zakqwy/NSA-B-GONE/HARDWARE/NSA-B-GONE.kicad_pcb

## KiCad design HARDWARE/NSA-B-GONE.kicad_pcb (2019-03-12)

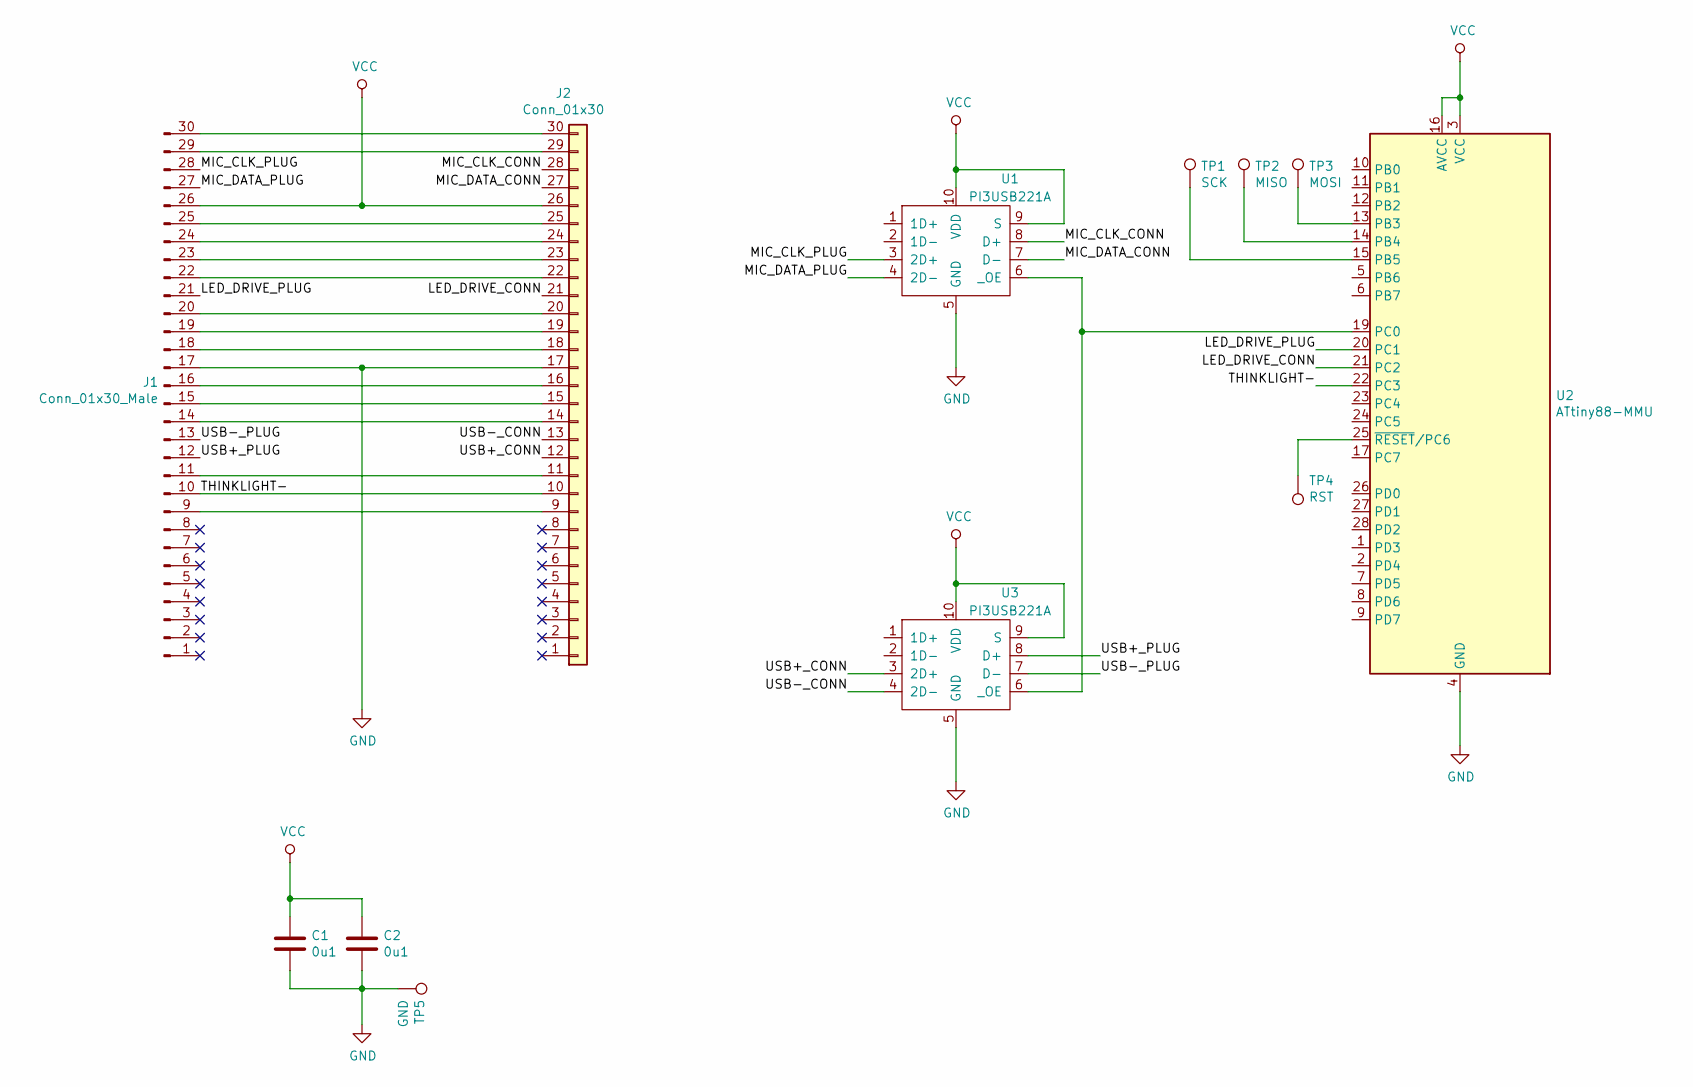
[picture p7: schematic NSA-B-GONE.sch]

Parts:
C1, C2: 0u1; C_0402_1005Metric
J1: Conn_01x30_Male; ZF_CONN_30PIN_FLEX_PLUG
J2: Conn_01x30; ZF_CONN_30PIN_FLEX_CONN
TP1: SCK; TestPoint_Pad_D1.5mm
TP2: MISO; TestPoint_Pad_D1.5mm
TP3: MOSI; TestPoint_Pad_D1.5mm
TP4: RST; TestPoint_Pad_D1.5mm
TP5: GND; TestPoint_Pad_1.5x1.5mm
U1, U3: PI3USB221A; ZF_IC_10_UQFN
U2: ATtiny88-MMU; QFN-28-1EP_4x4mm_P0.45mm_EP2.4x2.4mm

Connections:
/LED_DRIVE_CONN: J2.21, U2.21 (PC2)
/LED_DRIVE_PLUG: J1.21, U2.20 (PC1)
/MIC_CLK_CONN: J2.28, U1.8 (D+)
/MIC_CLK_PLUG: J1.28, U1.3 (2D+)
/MIC_DATA_CONN: J2.27, U1.7 (D-)
/MIC_DATA_PLUG: J1.27, U1.4 (2D-)
/THINKLIGHT-: J1.10, J2.10, U2.22 (PC3)
/USB+_CONN: J2.12, U3.3 (2D+)
/USB+_PLUG: J1.12, U3.8 (D+)
/USB-_CONN: J2.13, U3.4 (2D-)
/USB-_PLUG: J1.13, U3.7 (D-)
GND: C1.2, C2.2, J1.17, J2.17, TP5.1, U1.5 (GND), U2.4 (GND), U2.18 (GND), U2.29 (GND), U3.5 (GND)
unnamed: J1.9, J2.9
unnamed: J1.11, J2.11
unnamed: J1.14, J2.14
unnamed: J1.15, J2.15
unnamed: J1.16, J2.16
unnamed: J1.18, J2.18
unnamed: J1.19, J2.19
unnamed: J1.20, J2.20
unnamed: J1.22, J2.22
unnamed: J1.23, J2.23
unnamed: J1.24, J2.24
unnamed: J1.25, J2.25
unnamed: J1.29, J2.29
unnamed: J1.30, J2.30
unnamed: TP1.1, U2.15 (PB5)
unnamed: TP2.1, U2.14 (PB4)
unnamed: TP3.1, U2.13 (PB3)
unnamed: TP4.1, U2.25 (~RESET~/PC6)
unnamed: U1.6 (_OE), U2.19 (PC0), U3.6 (_OE)
VCC: C1.1, C2.1, J1.26, J2.26, U1.9 (S), U1.10 (VDD), U2.3 (VCC), U2.16 (AVCC), U3.9 (S), U3.10 (VDD)

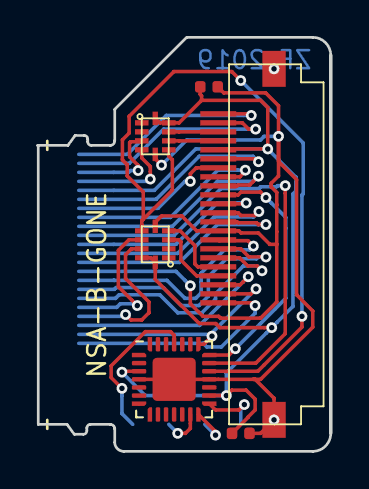
[picture p8: board NSA-B-GONE.kicad_pcb from above]

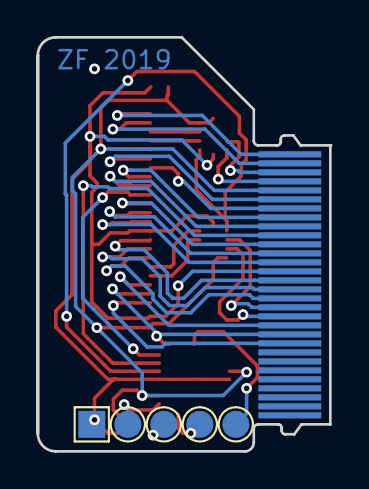
[picture p9: board NSA-B-GONE.kicad_pcb from below]

Board: 2 copper layers, 16.3 x 23.0 mm, 12 parts (6 on the bottom side), 32 nets.
