zakqwy/NSA-B-GONE/(threads)

Thread 1 (2019-03-16):

Portability to x230?

tlaurion, 2019-03-16:
@zakqwy ?

zakqwy, 2019-03-19:
This came up a few weeks ago in a Reddit thread here: https://www.reddit.com/r/thinkpad/comments/b0g2jh/i_made_a_webcammicrophone_hardware_kill_switch/eiep3bu

I dusted off (well, partially dusted off) my old X230 and pulled off the keyboard; the IO cable appears to use the same 30-pin FPC connector but I did not test it. Getting the first prototype to work with my X220 took some fiddling since the flat flex is too thin, so I didn't want to pull it out. It's something I'll check if I do another rev.

zakqwy, 2019-03-19:
Re-opening until this is tested.

tlaurion, 2020-10-28:
@zakqwy : I would love to generalize this to all xx20 and xx30 platforms. Do you have some time?
Tried to follow you and hit you up on twitter, but your account doesn't exist anymore.

Want to contact me from methods exposed [here](https://insurgo.ca/#contact)?

kusky3, 2021-02-14:
this guy went missing after creating a P.E.T. mentioning NSA.

F

Thread 2 (2019-03-16):

Explicitly present current design problems

tlaurion, 2019-03-16:
`I will tell you what needs to be done (if you're so inclined), or how you can make the existing design work.`

@zakqwy : Please do :)

zakqwy, 2019-03-19:
Hey! Thanks for the comment. Right now there are three problems I've identified. I think I know how to fix them, I just don't have the time right now:

1. The fab service I used for the prototype doesn't produce flat flex boards at the same thickness as the measured cable end. I think the cable end either has a stiffener or it's made of thicker polyamide. I had to shim the prototype using a few thicknesses of tape which resulted in a somewhat unreliable connection. Solution here is to try a thicker (or stiffened) flat flex part from another fab.
2. Rather than measure the existing cable, I designed the plug end cutout based on the Molex FPC connector's spec sheet. The prototype's cable end is a bit short compared to the original cable, which may also contribute to the somewhat unreliable connection. Solution here is to measure the existing IO cable, compare it to the design, and modify the design as needed to better copy the existing IO cable.
3. The Molex connector is mounted too far up on the screen. I miscalculated the offset from my initial measurements so the connector hits the back of the battery tray, necessitating some connector surgery. Solution here is to move the Molex connector down in the PCB design, but this will take a bit of routing as a few of the lines jump around to the USB switches.

While I'm doing some rerouting, I'll also probably lengthen the board a bit so the connector doesn't need to be butchered more to fit around the ATtiny88. And if I'm doing all that, I might as well switch to a more ubiquitous ATtinyx5, or maybe one of those super tiny 8-DFN ATtiny4/5/9/10s (2x2mm!). I may get to this over summer '19 but no guarantees.

tlaurion, 2019-05-05:
@BlackMaria?

BlackMaria, 2019-05-06:
Yeah, my theory was to either make the boards on mica which zak's fab doesnt offer (but, I have access to a role of mica/copper pcb paper).

Otherwise, just an idea if mica is too expensive/difficult to print a full PCB, and if you can find a some mica pcb paper scraps ( adafruit sells 6x6 for 10$ ):
1. Flip the pins on the molex connector, and place it on the other side of the PCB, and send that to the fab.
1. DIY make a mica pcb with two joined molex footprints ( or just a bunch of molex spaced lines across the whole sheet and cut as needed )
1. reflow the mica pcb to the fiberglass one.

The end result of this would have a protruding mica connector with enough space to fit the connector
Does that sound interesting?

tlaurion, 2019-06-14:
@zakqwy?

zakqwy, 2019-06-14:
I think that is an interesting path to explore, I just don't have the time to spin a new board. I'll happily accept a PR if you test this and it works!

tlaurion, 2020-01-28:
@BlackMaria : any progress on a design?

Closed 2024-04-16.
