zakqwy/NSA-B-GONE/(notices)

Notices in the files:
FIRMWARE/main.c:
The MIT License (MIT)
Copyright (c) 2019 by Zach Fredin
